weimulong/Four-MOS-DC-DC-Power/hardware/README.md

# 硬件原理说明

本项目采用四开关同步 Buck-Boost 拓扑，以 STM32F334 为数字控制核心，实现 5-50 V 可调输出、最大 2 A 输出电流和最大 100 W 输出功率。硬件主要由辅助电源、主控、功率变换与栅极驱动、信号采样和人机接口组成。

> 电压、电流和功率是需要同时满足的上限。例如，50 V 输出时受 100 W 功率限制，最大输出电流为 2 A；低电压输出时同样不得超过 2 A。

## 原理图文件

- [主控与辅助电源](schematics/SCH_主控与辅助电源.pdf)
- [主功率与驱动电路](schematics/SCH_主功率与驱动电路.pdf)
- [信号处理](schematics/SCH_信号处理.pdf)

当前三个 PDF 都包含同一套完整的 3 页原理图，文件名用于按功能模块分类和检索。

## 1. 四开关 Buck-Boost 功率级

功率级由两组同步半桥、储能电感 L4（22 uH）以及输入/输出滤波电容组成。Q1、Q2 构成输入侧半桥，Q3、Q4 构成输出侧半桥，中间通过电感传递能量。
BUCK-BOOST拓扑图
- 降压模式（Buck）：输入侧半桥进行 PWM 调制，输出侧主要承担同步续流。
- 升压模式（Boost）：输出侧半桥进行 PWM 调制，输入侧主要承担同步导通。
- 混合模式（Buck-Boost）：两侧半桥配合调制，用于输入与输出电压接近时的平滑过渡。

四个功率 MOSFET 采用互补驱动。控制程序必须保证上下管具有足够死区，禁止同一桥臂上下管同时导通，否则会造成直通短路。输入端和输出端均布置了大容量与高频旁路电容，以降低开关电流造成的母线纹波。

## 2. MOSFET 栅极驱动

两片 SI8233BD-D-ISR 双通道隔离栅极驱动器分别驱动输入侧和输出侧半桥。STM32F334 的 HRTIM 输出 `PWM1H/PWM1L` 和 `PWM2H/PWM2L`，经驱动器转换为四路 MOSFET 栅极信号。

驱动侧使用 12 V 供电，栅极串联电阻用于限制充放电峰值电流并调节开关速度，栅源下拉电阻用于在驱动失效或上电过程中保持 MOSFET 可靠关断。驱动电源附近的去耦电容应尽量靠近芯片电源引脚布置。

## 3. 主控与辅助电源

主控采用 STM32F334C8T6。该器件的 HRTIM 适合产生高分辨率互补 PWM，ADC 用于同步采集输入/输出电压、电流及调节电位器信号。板上同时预留 SWD、I2C OLED、按键和状态指示灯接口。

辅助电源通过二极管从 `VIN+` 或 `VOUT+` 取电，随后由 XL7005A 降压得到约 12 V，再通过 AMS1117-5.0 和 AMS1117-3.3 产生 5 V 与 3.3 V。模拟 3.3 V 电源 `A3V3` 经过 LC 滤波，以降低数字和开关噪声对 ADC 基准及采样信号的影响。

## 4. 电压与电流采样


输入、输出电压均采用差分运算放大器采样。68 kΩ 输入电阻与 3.3 kΩ 反馈/基准电阻将高压差分信号按比例缩小，再经 100 Ω 与 330 pF RC 网络送入 `ADC_VIN` 和 `ADC_VOUT`。差分采样有助于减小功率地线上压降对测量结果的影响。

输入和输出回路分别使用 10 mΩ 分流电阻检测电流。运算放大器以约 1.65 V 为零电流偏置，并通过 15 kΩ/100 Ω 电阻网络放大采样信号，输出 `ADC_IIN` 和 `ADC_IOUT`。这种偏置方式允许 ADC 表示正、负方向电流，适合双向功率流检测。

调节电位器产生 `ADC_VADJ`，供软件计算输出电压参考值。1.65 V 中点电压由 3.3 V 分压并经运算放大器缓冲，为电流采样通道提供稳定偏置。

## 5. 控制与保护关系

STM32F334 根据 ADC 反馈计算控制误差，通过数字 PI/PID 环路更新 HRTIM 占空比，并依据输入、输出电压关系切换 Buck、Boost 或混合模式。软件同时利用采样结果执行输入欠压/过压、输出过压、过流和短路保护。

硬件调试时应依次确认：

1. 12 V、5 V、3.3 V 和 A3V3 电源正常。
2. 四路 PWM 极性、频率、死区和驱动幅度正确。
3. 不接功率负载时校准电压、电流采样零点和比例。
4. 使用限流电源从低电压、低占空比开始测试功率级。
5. 在扩大输出范围前验证过压、过流、短路和温升保护。

## 安全提示

本电路最高输出电压为 50 V，且包含高频大电流开关节点。调试时应使用隔离与限流措施，避免带电插拔、探头地夹误接和桥臂直通。原理图参数是设计依据，不等同于安全认证或所有工况下的保证值。
