weimulong/Four-MOS-DC-DC-Power/hardware/schematics/SCH_主功率与驱动电路.pdf

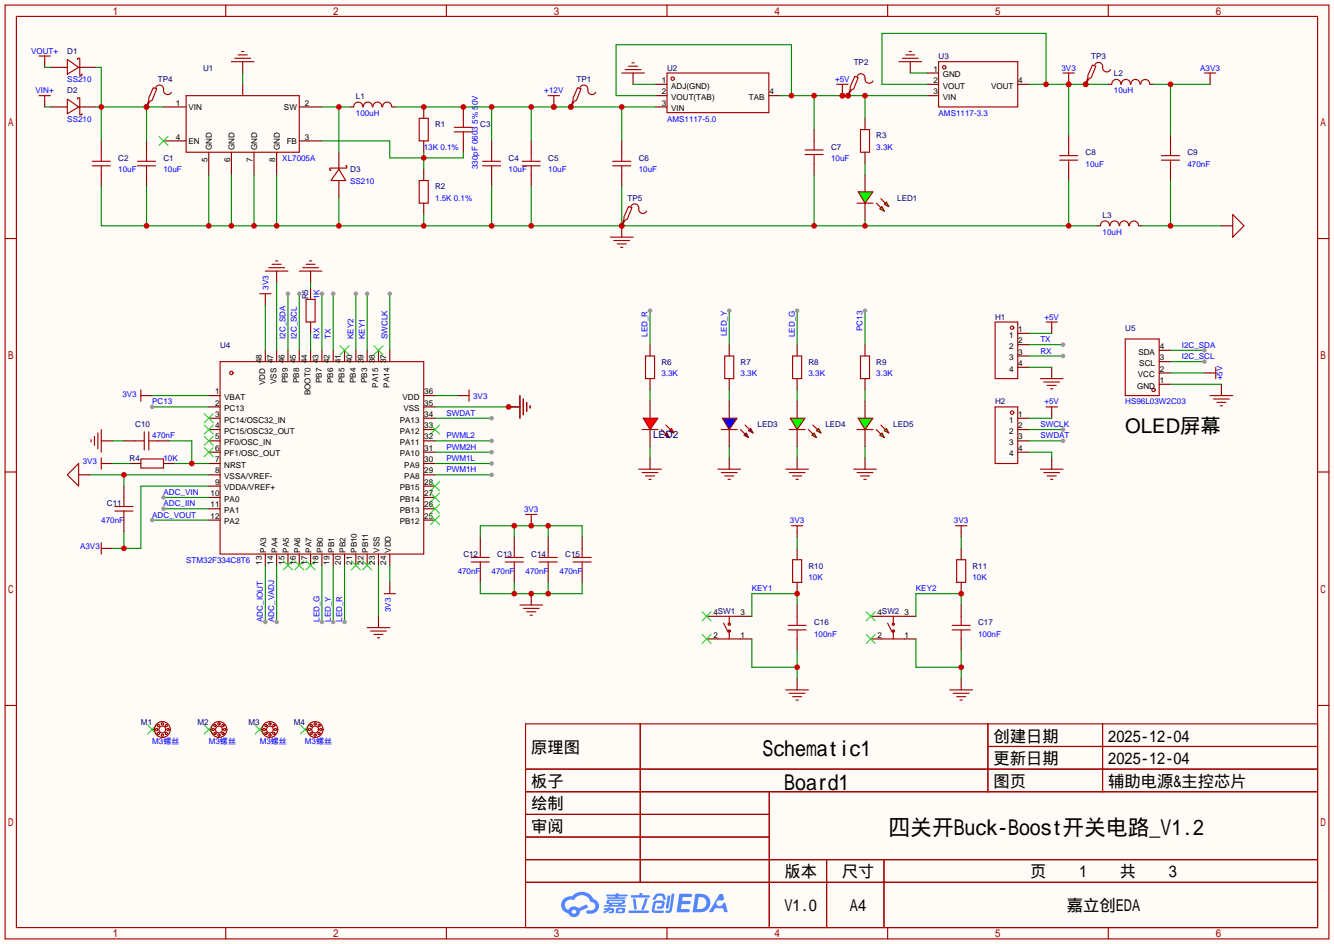
[picture p1: page 1]

原理图 | Schematic1 | 创建日期 | 2025-12-04

更新日期 | 2025-12-04

板子 | Board1 | 图页 | 辅助电源&主控芯片
绘制 | | 四关开Buck-Boost开关电路_V1.2
审阅

V1.0 | A4 | 嘉立创EDA

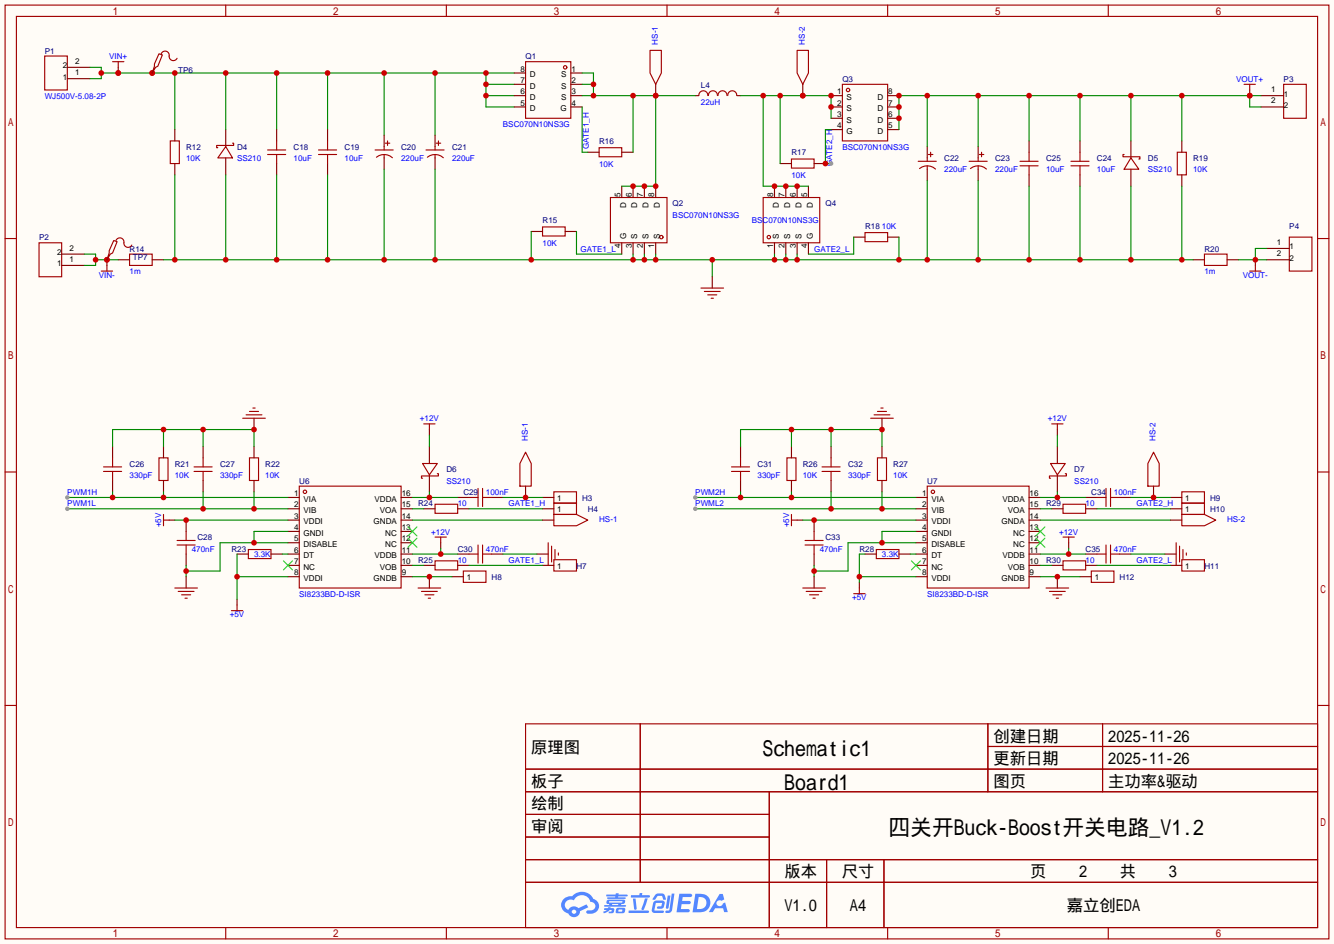
[picture p2: page 2]

VOB 10 VDDB 11 NC 12 NC 13 GNDA 14 VOA 15 VDDA 16

原理图 | Schematic1 | 创建日期 | 2025-11-26

更新日期 | 2025-11-26

板子 | Board1 | 图页 | 主功率&驱动
绘制 | | 四关开Buck-Boost开关电路_V1.2
审阅

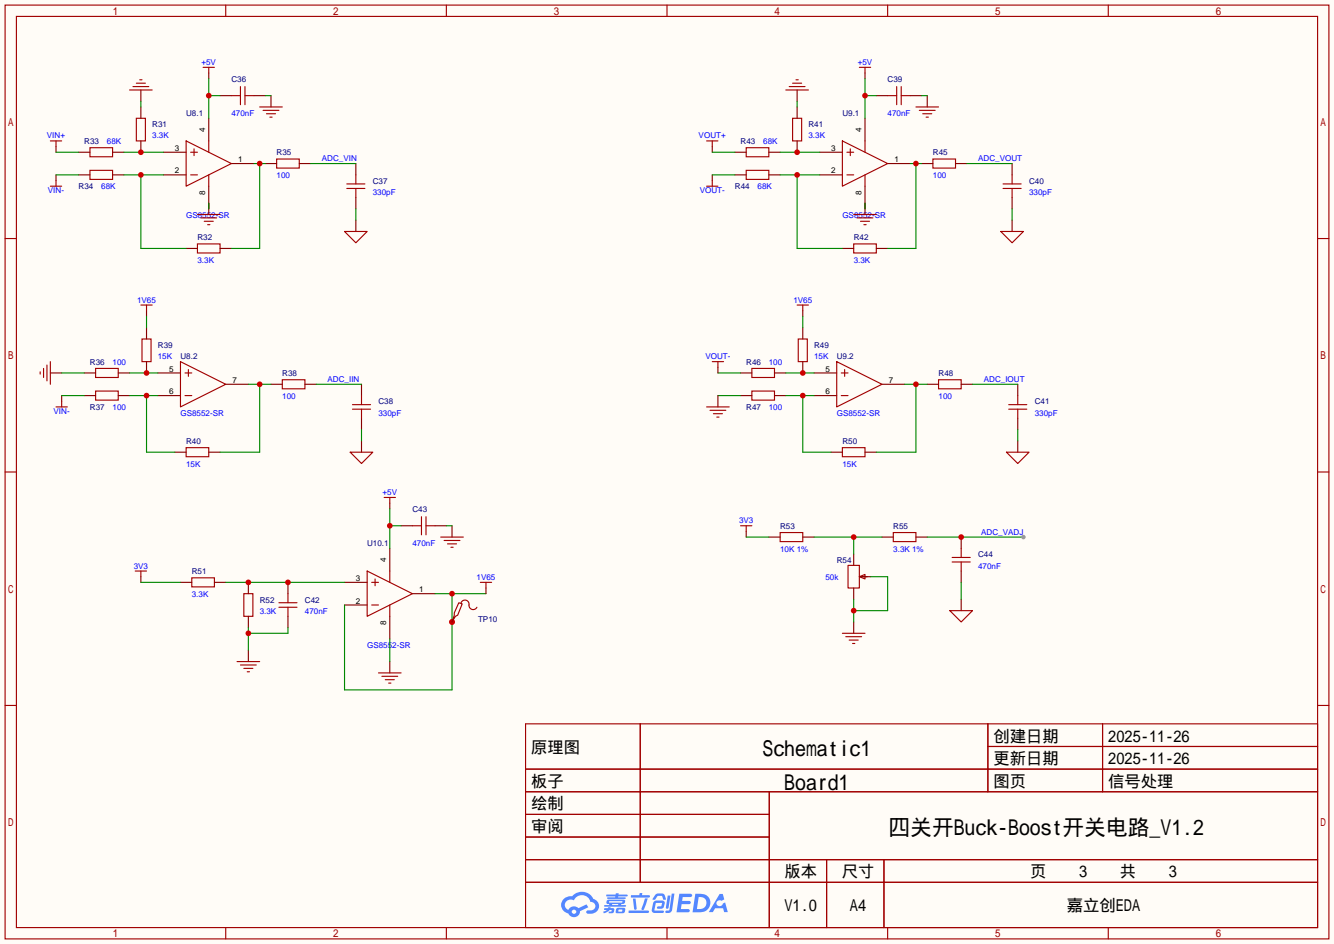
[picture p3: page 3]

原理图 | Schematic1 | 创建日期 | 2025-11-26

更新日期 | 2025-11-26

板子 | Board1 | 图页 | 信号处理
绘制 | | 四关开Buck-Boost开关电路_V1.2
审阅
