weimulong/Four-MOS-DC-DC-Power/(list of files, drawings)

Other design files:
hardware/eda/ProPrj_四关开Buck-Boost开关电路_V1.2_2026-08-30.epro
