weimulong/Four-MOS-DC-DC-Power/firmware/Core/Src/main.c

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
/* Includes ------------------------------------------------------------------*/
#include "main.h"
#include "adc.h"
#include "dma.h"
#include "hrtim.h"
#include "hrtim.h"
#include "i2c.h"
#include "tim.h"
#include "gpio.h"

/* USER CODE BEGIN Includes */
#include "oled.h"
#include "function.h"
/* USER CODE END Includes */


void SystemClock_Config(void);
/**
  * @brief  The application entry point.
  * @retval int
  */
int main(void)
{
  /* MCU Configuration--------------------------------------------------------*/

  /* Reset of all peripherals, Initializes the Flash interface and the Systick. */
  HAL_Init();

  /* Configure the system clock */
  SystemClock_Config();

  /* Initialize all configured peripherals */
  MX_GPIO_Init();
  MX_DMA_Init();
  MX_HRTIM1_Init();
  MX_ADC1_Init();
  MX_ADC2_Init();
  MX_I2C1_Init();
  MX_TIM3_Init();
  /* USER CODE BEGIN 2 */
	MX_OLED_Init();//OLED显示屏初始化	
	HAL_TIM_Base_Start_IT(&htim3);//启动定时器2 200Hz
	HAL_ADC_Start_DMA(&hadc1, (uint32_t*)ADC1_RESULT, 4);//启动ADC1采样 DMA数据传送采样输入输出电压电流
	HAL_ADC_Start(&hadc2);//启动ADC2采样，采样滑动电位器电压	
	HAL_HRTIM_WaveformOutputStart(&hhrtim1, HRTIM_OUTPUT_TA1|HRTIM_OUTPUT_TA2); //开启PWM输出和PWM计时器
	HAL_HRTIM_WaveformOutputStart(&hhrtim1, HRTIM_OUTPUT_TB1|HRTIM_OUTPUT_TB2); //开启PWM输出和PWM计时器
	HAL_HRTIM_WaveformCountStart(&hhrtim1, HRTIM_TIMERID_TIMER_A);//开启PWM输出和PWM计时器
	HAL_HRTIM_WaveformCountStart(&hhrtim1, HRTIM_TIMERID_TIMER_B);//开启PWM输出和PWM计时器
	__HAL_HRTIM_TIMER_ENABLE_IT(&hhrtim1,HRTIM_TIMERINDEX_TIMER_A,HRTIM_TIM_IT_REP);
	/*HAL_NVIC_SetPriority(HRTIM1_TIMA_IRQn,1,0); //抢占优先级为3，子优先级为3
  HAL_NVIC_EnableIRQ(HRTIM1_TIMA_IRQn); //使能中断线13
	HAL_NVIC_SetPriority(TIM2_IRQn,2,0); //抢占优先级为3，子优先级为3
  HAL_NVIC_EnableIRQ(TIM2_IRQn); //使能中断线13*/
  /* USER CODE END 2 */

  /* Infinite loop */
  /* USER CODE BEGIN WHILE */
  while (1)
  {
    /* USER CODE END WHILE */

    /* USER CODE BEGIN 3 */
		if(OLEDShowCnt>60)//300m刷新一次
		{
			OLEDShowCnt=0;
			OLEDShow();
		}
  }
  /* USER CODE END 3 */
}

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
