weimulong/Four-MOS-DC-DC-Power/firmware/Core/Inc/main.h

#define ADCVin_Pin GPIO_PIN_0
#define ADCVin_GPIO_Port GPIOA
#define ADCIin_Pin GPIO_PIN_1
#define ADCIin_GPIO_Port GPIOA
#define ADCVout_Pin GPIO_PIN_2
#define ADCVout_GPIO_Port GPIOA
#define ADCIout_Pin GPIO_PIN_3
#define ADCIout_GPIO_Port GPIOA
#define ADCVadj_Pin GPIO_PIN_4
#define ADCVadj_GPIO_Port GPIOA
#define LED_G_Pin GPIO_PIN_0
#define LED_G_GPIO_Port GPIOB
#define LED_Y_Pin GPIO_PIN_1
#define LED_Y_GPIO_Port GPIOB
#define LED_R_Pin GPIO_PIN_2
#define LED_R_GPIO_Port GPIOB
#define KEY_1_Pin GPIO_PIN_3
#define KEY_1_GPIO_Port GPIOB
#define KEY_2_Pin GPIO_PIN_4
#define KEY_2_GPIO_Port GPIOB
