weimulong/Four-MOS-DC-DC-Power/firmware/Core/Inc/oledfont.h

  #ifndef __OLEDFONT_H
    #define __OLEDFONT_H 	   
    // ------------------  ASCII字模的数据表 ------------------------ //
    // 码表从0x20~0x7e                                                //
    // 字库:  纵向取模下高位// （调用时要减512）
    // -------------------------------------------------------------- //
    
    	unsigned char F16x16[] =
    {
    //	0x00,0x00,0x00,0x00,0x00,0xF0,0x08,0x04,0x04,0x08,0xF0,0x00,0x00,0x00,0x00,0x00,
    //	0x00,0x00,0x00,0x00,0x00,0x07,0x08,0x10,0x10,0x08,0x07,0x00,0x00,0x00,0x00,0x00,
    	
    	0x10,0x94,0x53,0x32,0x1E,0x32,0x52,0x10,0x00,0x7E,0x42,0x42,0x42,0x7E,0x00,0x00,
    	0x00,0x00,0x00,0xFF,0x49,0x49,0x49,0x49,0x49,0x49,0x49,0xFF,0x00,0x00,0x00,0x00,/*"智”,0*/
    
    	0x08,0xCC,0x4A,0x49,0x48,0x4A,0xCC,0x18,0x00,0x7F,0x88,0x88,0x84,0x82,0xE0,0x00,
    	0x00,0xFF,0x12,0x12,0x52,0x92,0x7F,0x00,0x00,0x7E,0x88,0x88,0x84,0x82,0xE0,0x00,/*"能",1*/
    
    	0x40,0x20,0xF0,0x28,0x24,0x27,0x24,0xE4,0x24,0x34,0x2C,0x20,0xE0,0x00,0x00,0x00,
    	0x40,0x40,0x4F,0x49,0x49,0x49,0x49,0x4F,0x49,0x49,0x49,0x49,0x4F,0x40,0x40,0x00,/*"鱼",2*/
    
    	0x50,0x48,0x47,0x44,0xFC,0x44,0x44,0x44,0x00,0x04,0x04,0xFC,0x04,0x04,0x04,0x00,
    	0x00,0x3E,0x20,0x20,0x3F,0x10,0x10,0x7E,0x20,0x20,0x20,0x3F,0x20,0x20,0x20,0x00,/*"缸",3*/
    
    	0x04,0x24,0x44,0x84,0x64,0x9C,0x40,0x30,0x0F,0xC8,0x08,0x08,0x28,0x18,0x00,0x00,
    	0x10,0x08,0x06,0x01,0x82,0x4C,0x20,0x18,0x06,0x01,0x06,0x18,0x20,0x40,0x80,0x00,/*"欢",4*/
    
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
    	0x00,0x00,0x06,0x06,0x06,0x06,0x06,0x00,0x00,0x00,0x00,0x00,0x00,0x00,0x00,0x00,
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
    	0x80,0xFF,0x80,0xEE,0xEE,0xEE,0xF5,0xFB,0xFF,0x9C,0xBE,0xB6,0xB6,0x88,0xFF,0x00,/*"D:\DreamSpark\OLED\MP3_UI.bmp",0*/
    };
    
    #endif
