weimulong/Four-MOS-DC-DC-Power/(commit log)

2026-08-31 Import four-switch Buck-Boost firmware and hardware project
    [ProPrj_四关开Buck-Boost开关电路_V1.2_2026-08-30.epro]
2026-08-31 Update project output ratings to 50V 2A 100W
2026-08-31 Add files via upload
    原理图PDF文件
2026-08-31 Create 硬件源文件
2026-08-31 Add hardware schematics and principle overview
